adamoell/RoboFootball/Documentation/Controller_Chassis_Unlabelled.jpg

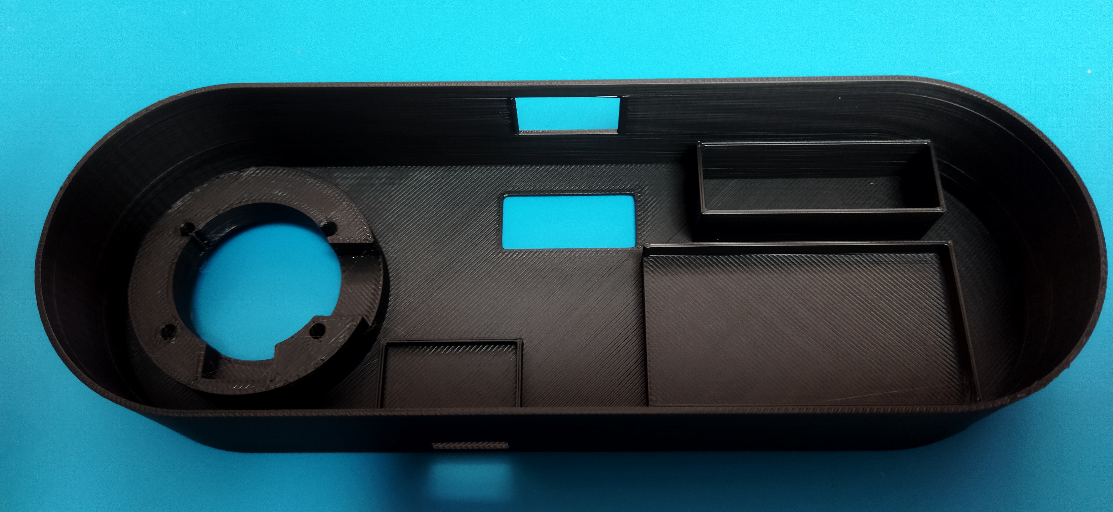
Documentation/Controller_Chassis_Unlabelled.jpg
