adamoell/RoboFootball/RoboFootballer.png

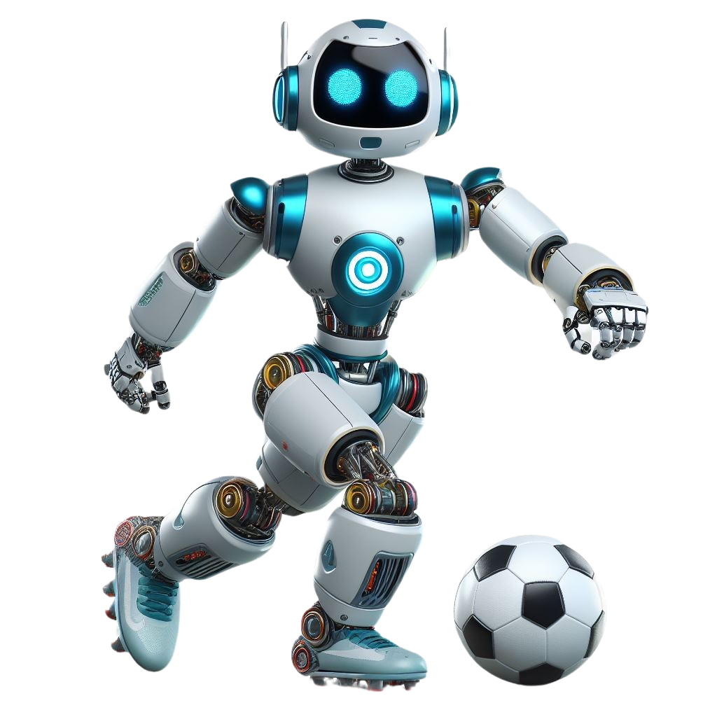
RoboFootballer.png
