adamoell/RoboFootball/3DPrinting/Robot/Kicker/9g-servo-dimensions.jpg

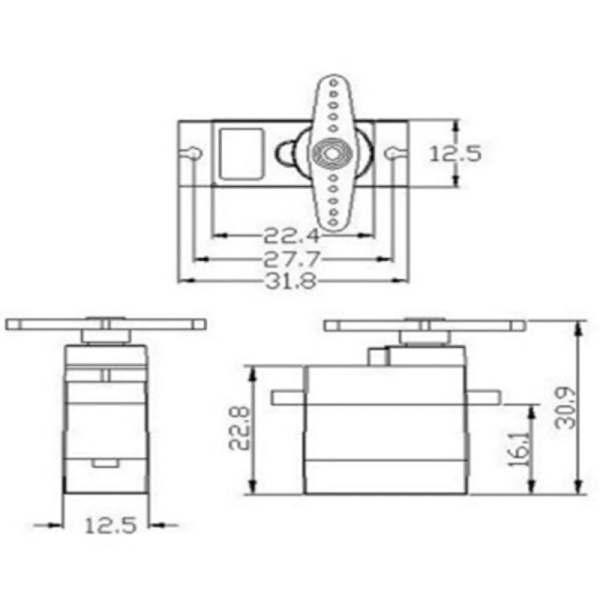
3DPrinting/Robot/Kicker/9g-servo-dimensions.jpg
