adamoell/RoboFootball/3DPrinting/Controller/controller.stl

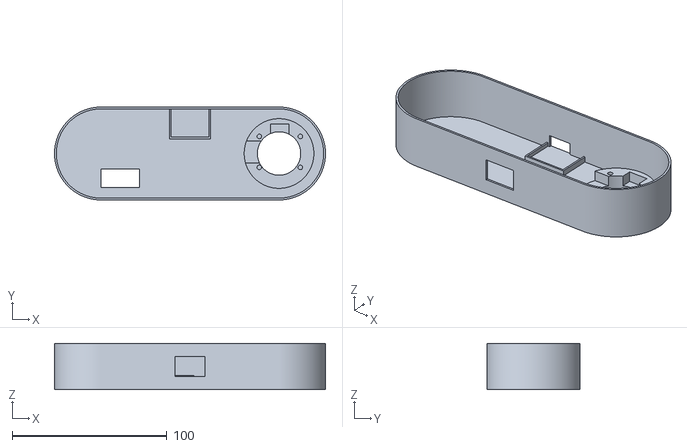
[picture p4: CAD file, 2024-08-09]
3DPrinting/Controller/controller.stl
175.0 x 60.0 x 30.0
