adamoell/RoboFootball/3DPrinting/Goals/goal_l.stl

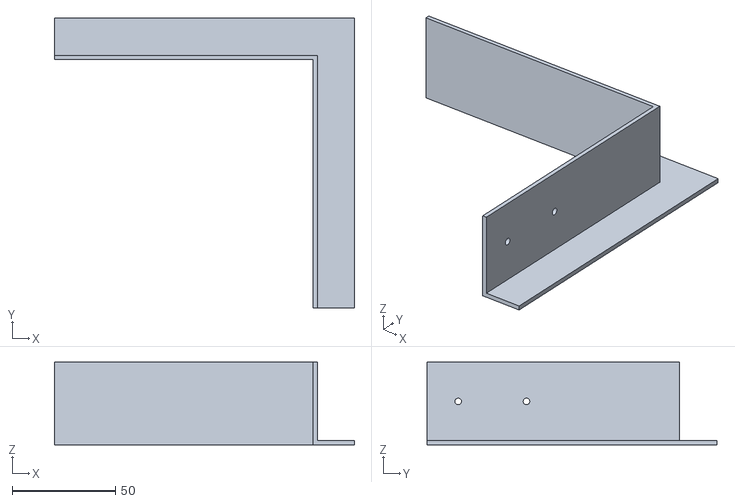
[picture p5: CAD file, 2024-08-09]
3DPrinting/Goals/goal_l.stl
145.0 x 140.0 x 40.0
