adamoell/RoboFootball/3DPrinting/Robot/Chassis/bms_cover.stl

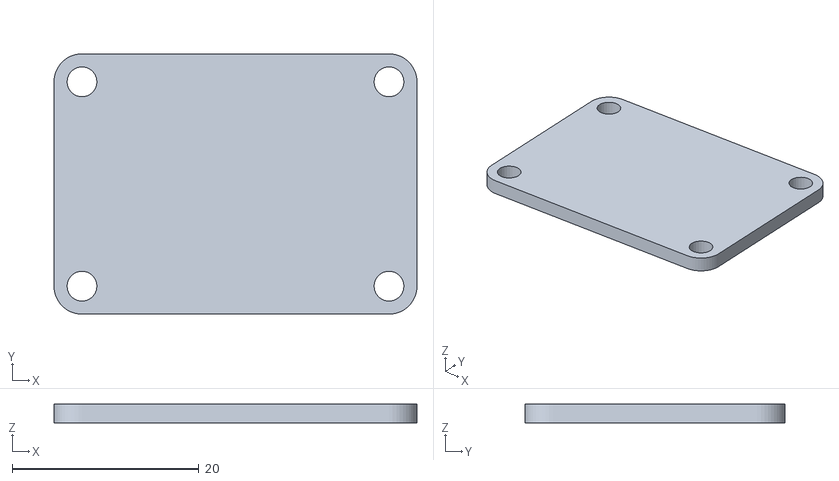
[picture p6: CAD file, 2024-08-09]
3DPrinting/Robot/Chassis/bms_cover.stl
38.9 x 27.9 x 2.00
