adamoell/RoboFootball/3DPrinting/Robot/Kicker/kicker.stl

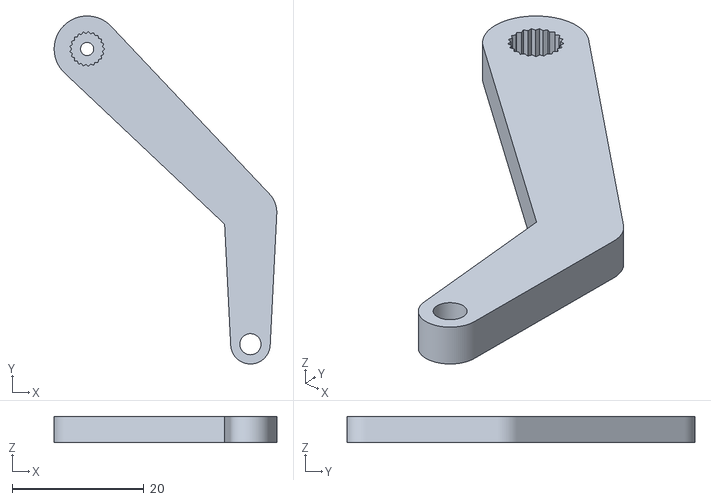
[picture p7: CAD file, 2024-08-09]
3DPrinting/Robot/Kicker/kicker.stl
33.7 x 52.7 x 4.00
