adamoell/RoboFootball/3DPrinting/Robot/switcher.stl

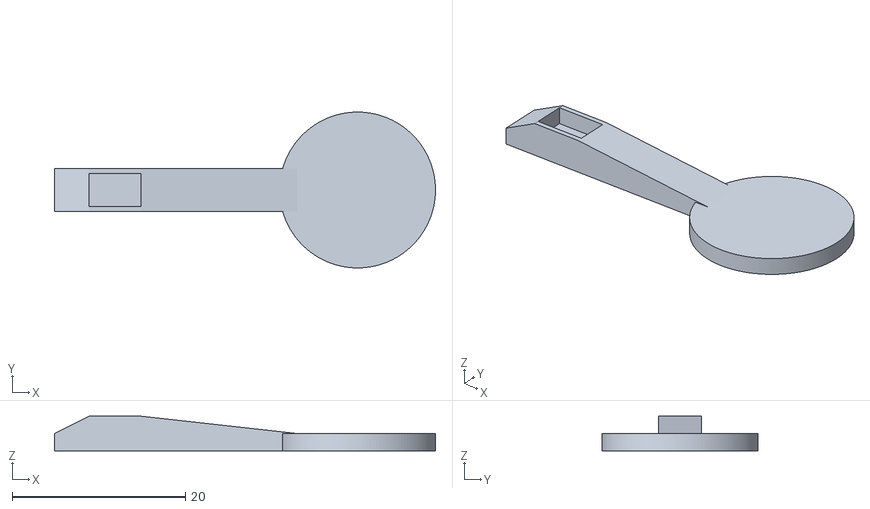
[picture p8: CAD file, 2024-08-09]
3DPrinting/Robot/switcher.stl
44.0 x 18.0 x 4.00
