adamoell/RoboFootball/3DPrinting/Wheels/tyre_mould_top_v2.stl

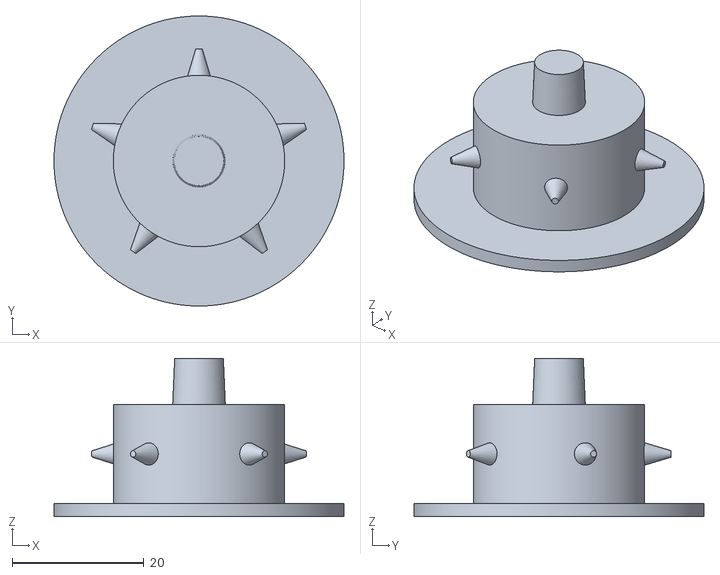
[picture p9: CAD file, 2024-08-09]
3DPrinting/Wheels/tyre_mould_top_v2.stl
44.0 x 44.0 x 24.0
