adamoell/RoboFootball/3DPrinting/Controller/controller_case.stl

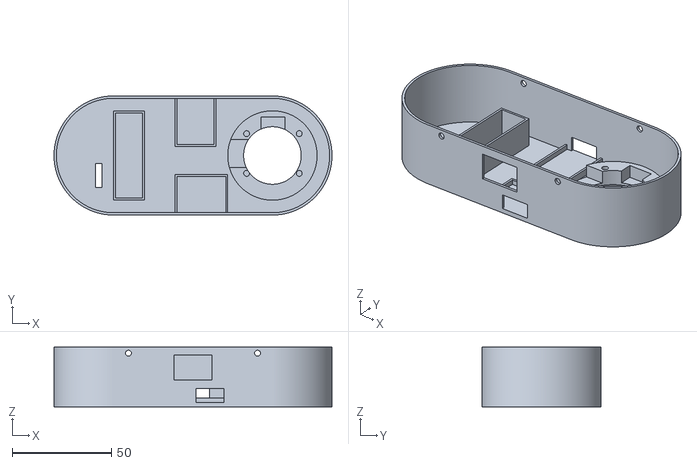
[picture p10: CAD file, 2024-08-09]
3DPrinting/Controller/controller_case.stl
140.0 x 60.0 x 30.0
