adamoell/RoboFootball/3DPrinting/Goals/goal_joiner.stl

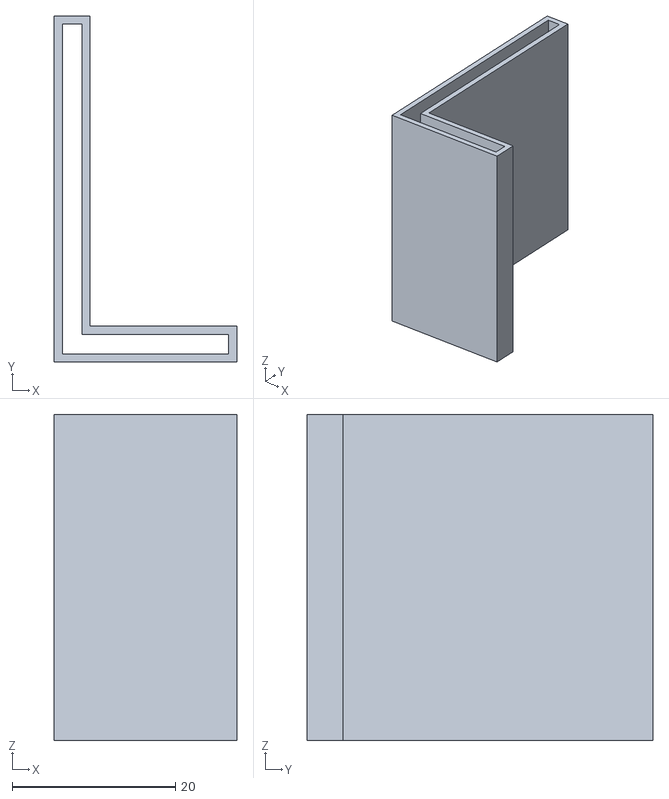
[picture p11: CAD file, 2024-08-09]
3DPrinting/Goals/goal_joiner.stl
22.4 x 42.4 x 40.0
