adamoell/RoboFootball/3DPrinting/Robot/Chassis/chassis.stl

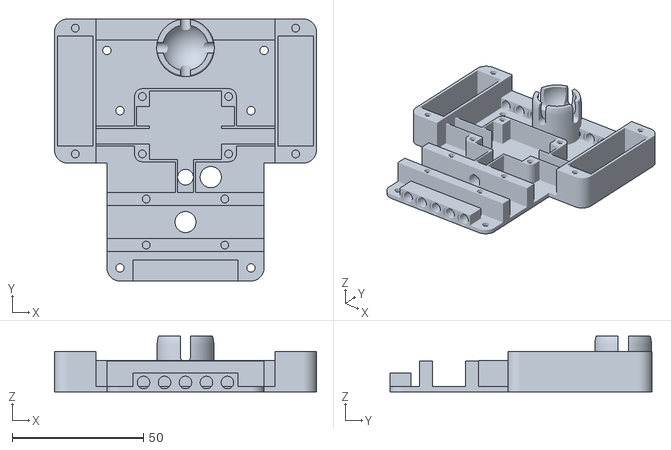
[picture p12: CAD file, 2024-08-09]
3DPrinting/Robot/Chassis/chassis.stl
100.0 x 100.0 x 21.3
