adamoell/RoboFootball/3DPrinting/Robot/Kicker/kicker_mount.stl

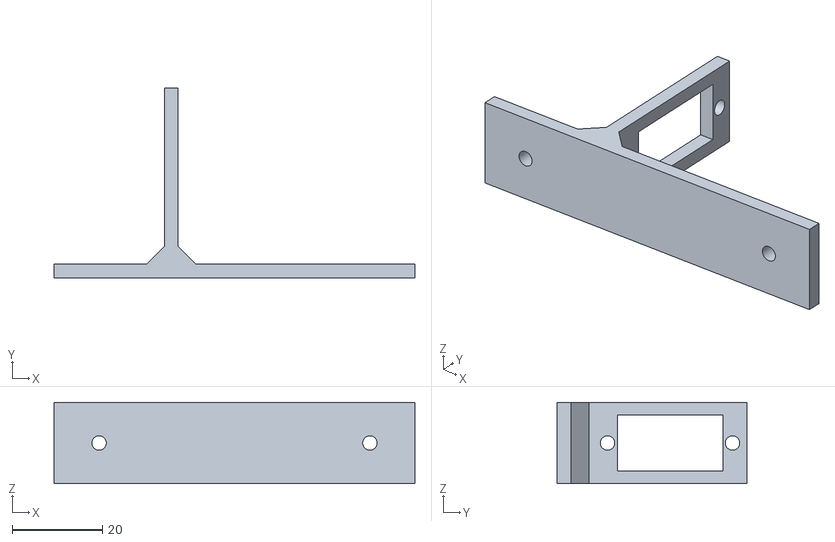
[picture p13: CAD file, 2024-08-09]
3DPrinting/Robot/Kicker/kicker_mount.stl
80.0 x 42.0 x 18.0
