adamoell/RoboFootball/3DPrinting/Wheels/wheel_v2.stl

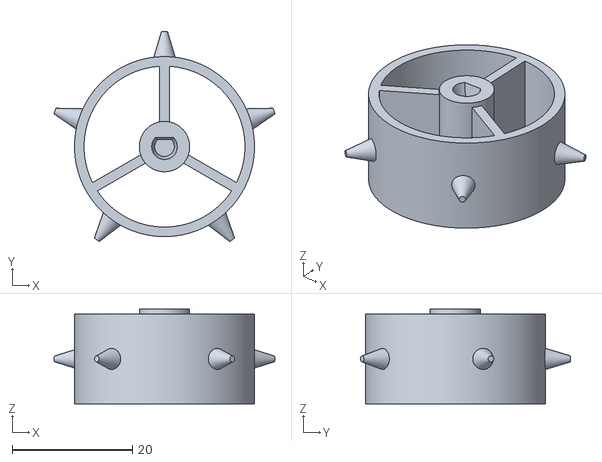
[picture p14: CAD file, 2024-08-09]
3DPrinting/Wheels/wheel_v2.stl
36.8 x 35.0 x 15.8
