adamoell/RoboFootball/3DPrinting/Controller/junctioninsulator.stl

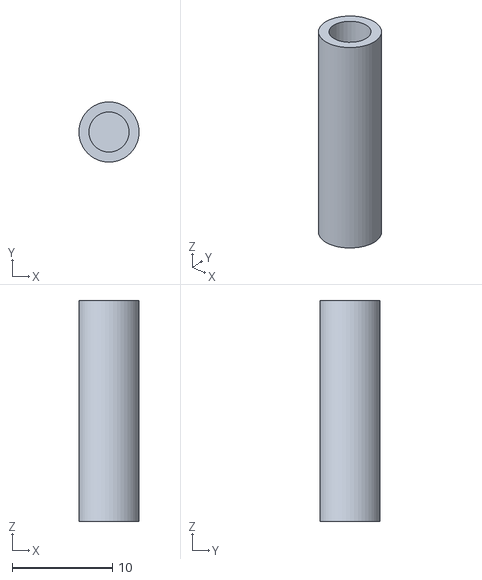
[picture p15: CAD file, 2024-08-09]
3DPrinting/Controller/junctioninsulator.stl
6.00 x 6.00 x 22.0
