adamoell/RoboFootball/3DPrinting/Robot/Chassis/motor_retainer.stl

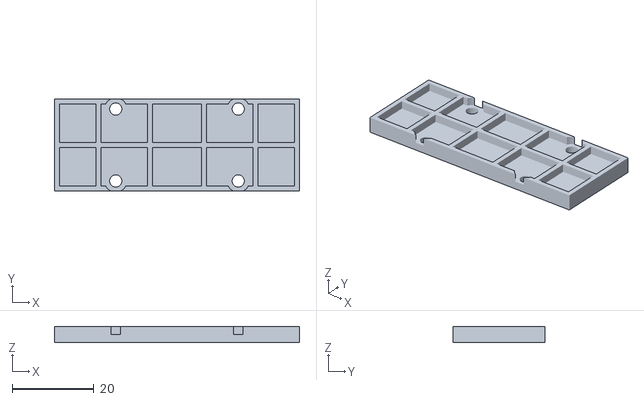
[picture p16: CAD file, 2024-08-09]
3DPrinting/Robot/Chassis/motor_retainer.stl
60.0 x 22.6 x 4.00
