adamoell/RoboFootball/3DPrinting/Robot/Kicker/kicker_boot.stl

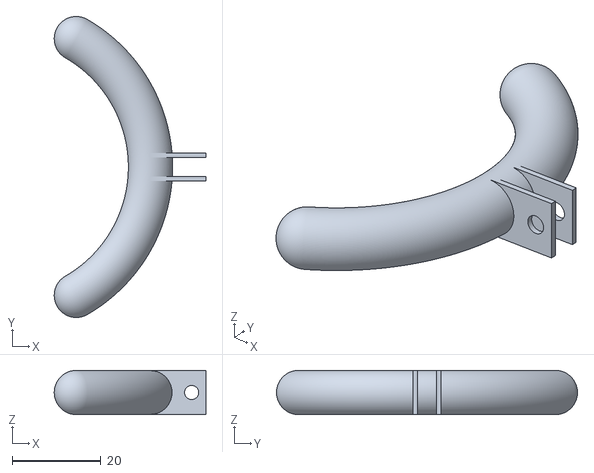
[picture p17: CAD file, 2024-08-09]
3DPrinting/Robot/Kicker/kicker_boot.stl
34.2 x 68.0 x 10.0
