adamoell/RoboFootball/3DPrinting/Wheels/tyre_mould_base_v2.stl

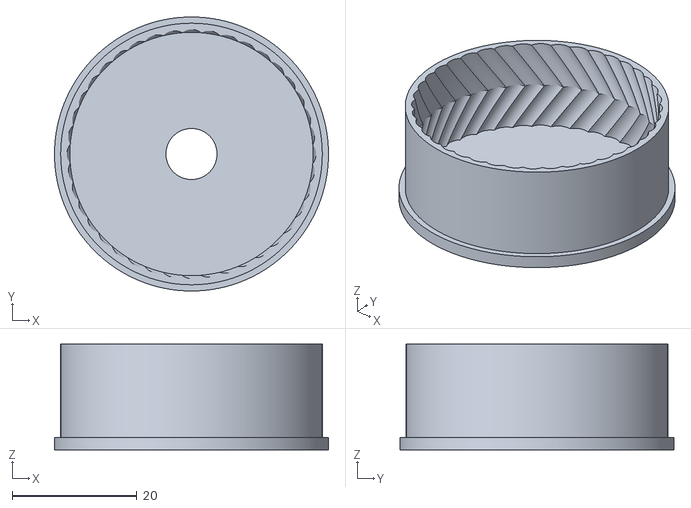
[picture p18: CAD file, 2024-08-09]
3DPrinting/Wheels/tyre_mould_base_v2.stl
44.0 x 44.0 x 17.0
