adamoell/RoboFootball/3DPrinting/Controller/controller_lid.stl

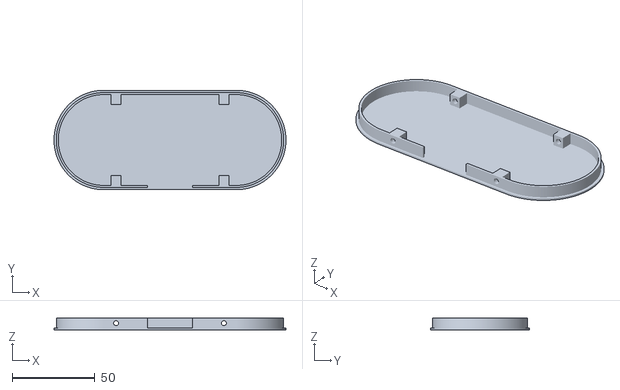
[picture p19: CAD file, 2024-08-09]
3DPrinting/Controller/controller_lid.stl
140.0 x 60.0 x 7.00
