adamoell/RoboFootball/3DPrinting/Robot/Chassis/canopy.stl

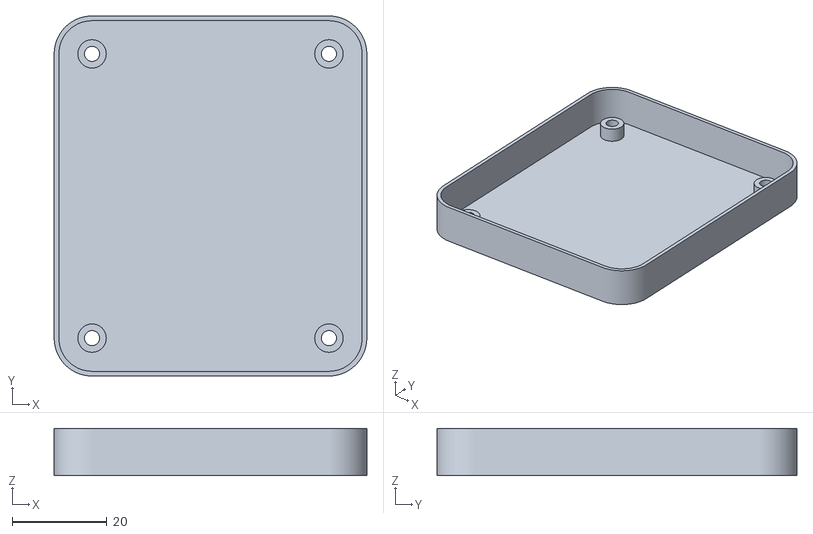
[picture p20: CAD file, 2024-08-09]
3DPrinting/Robot/Chassis/canopy.stl
66.0 x 76.0 x 10.0
