adamoell/RoboFootball/3DPrinting/Robot/Chassis/batt_chamber_cover.stl

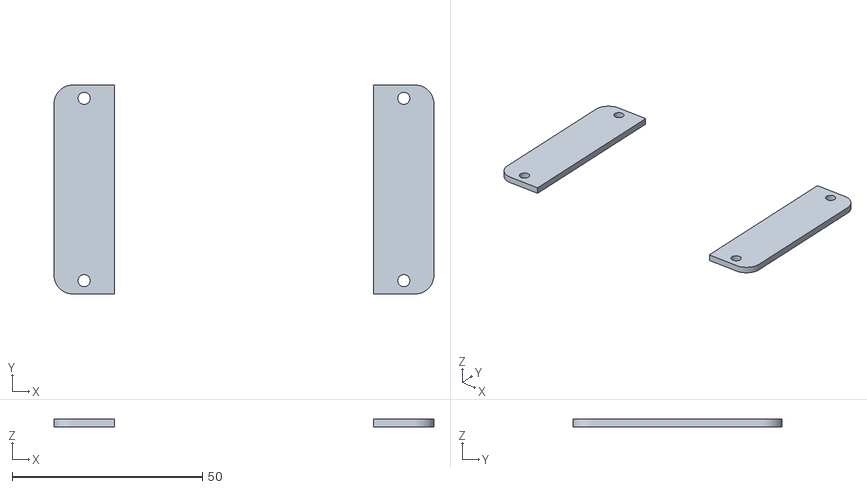
[picture p21: CAD file, 2024-08-09]
3DPrinting/Robot/Chassis/batt_chamber_cover.stl
100.0 x 55.0 x 2.00
