adamoell/RoboFootball/(list of files, cad)

Other CAD files:
3DPrinting/Goals/goal_r.stl
