adamoell/RoboFootball/(list of files, drawings)

Other design files:
PCB/PCB_RoboFootball.json
PCB/SCH_RoboFootball.json
