adamoell/RoboFootball/Code/Robot/servo.py

'''
servo.py: servo motor control library
Copyright (C) 2024 by Adam Oellermann (adam@oellermann.com)
--------------------------------------------------------------------------------
This file is part of RoboFootball.

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
You should have received a copy of the GNU General Public License along with
RoboFootball. If not, see <https://www.gnu.org/licenses/>.
'''
from machine import Pin, PWM
from time import sleep

class Servo:
    def __init__(self, pin, pwm_freq):
        '''
        Inititalise the servo.
        --
        pin: the GPIO pin the servo is connected to
        min_duty: the minimum duty cycle the servo moves at (corresponding to min_angle) (26)
        max_duty: the duty cycle corresponding to max_angle (118)
        min_angle: the minimum angle for the servo (0°)
        max_angle: the maximum angle for the servo (180°)
        pwm_freq: the PWM frequency for the servo (50Hz)
        '''
        self.pwm_freq = pwm_freq
        self.current_duty = None
        self.calibrated = False
        self.servo_pin = pin
        self.servo = PWM(Pin(pin, mode=Pin.OUT))
        self.servo.freq(pwm_freq)

    def auto_calibrate(self, min_duty_spec, max_duty_spec, min_angle, max_angle):
        '''
        Calculate and set calibration values for the servo.
        Manual calibration may yield slightly better results for individual servos.
        --
        min_duty_spec: the duty cycle corresponding to the minimum angle in the spec (0° - 2.5%=0.025 for SG90)
        max_duty_spec: the duty cycle corresponding to the maximum angle in the spec (180° - 12.5%=0.125 for SG90)
        min_angle: the minimum angle for the servo (0°)
        max_angle: the maximum angle for the servo (180°)
        '''
        min_duty = round(min_duty_spec * 1024) # 1024 is the duty cycle range of the ESP
        max_duty = round(max_duty_spec * 1024)
        #print("Autocalibration: min_duty={} max_duty={}".format(min_duty, max_duty))
        self.calibrate(min_duty, max_duty, min_angle, max_angle)
        
    def calibrate(self, min_duty, max_duty, min_angle, max_angle):
        self.min_angle = min_angle
        self.max_angle = max_angle
        self.min_duty = min_duty
        self.max_duty = max_duty
        self.calibrated = True
        
    def degrees_to_duty(self, angle):
        '''
        Convert a given angle in degrees to the appropriate duty cycle.
        --
        angle: the angle in degrees
        '''
    
        angle_fraction = (angle-self.min_angle)/(self.max_angle-self.min_angle)
        duty_range = self.max_duty - self.min_duty
        duty = int(self.min_duty + (angle_fraction * duty_range))
        #print("angle: {} duty: {}".format(angle, duty))
        return(duty)

    def goto(self, angle):
        '''
        Move the servo to a specified angle.
        --
        angle: the angle to move the servo to.
        '''
        if self.calibrated:
            self.goto_duty(self.degrees_to_duty(angle))
        else:
            print("Uncalibrated")
        
    def goto_duty(self, duty):
        '''
        Move the servo by specifiying a duty cycle.
        --
        duty: the duty cycle to send to the servo.
        '''
        if duty != self.current_duty:
            self.servo.freq(self.pwm_freq)
            self.current_duty = duty
            self.servo.duty(duty)

        
class Kicker():
    def __init__(self, pin, freq, rest_angle, kick_angle):
        self.servo = Servo(pin, pwm_freq=freq)
        self.rest_angle = rest_angle
        self.kick_angle = kick_angle
        sg90_min_duty = 0.025 # 2.5% duty cycle for 0° (according to spec)
        sg90_max_duty = 0.125 # 12.5% duty cycle for 180° (according to spec)
        self.servo.auto_calibrate(sg90_min_duty, sg90_max_duty, 0, 180)
        self.down()

    def up(self):
        self.servo.goto(self.kick_angle)
    
    def down(self):
        self.servo.goto(self.rest_angle)
        
    def kick(self):
        print(self.servo.servo)
        self.up()
        sleep(0.1)
        self.down()
