adamoell/RoboFootball/Code/Robot/fx.py

'''
fx.py: robot visual fx
Copyright (C) 2024 by Adam Oellermann (adam@oellermann.com)
--------------------------------------------------------------------------------
This file is part of RoboFootball.

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
You should have received a copy of the GNU General Public License along with
RoboFootball. If not, see <https://www.gnu.org/licenses/>.
'''
import machine, neopixel
from time import sleep
from time import ticks_ms

BLACK = (0,0,0)
RED = (255,0,0)
ORANGE = (255,63,0)
YELLOW = (255,160,0)
GREEN = (0,255,0)
AQUA = (0,255,255)
BLUE = (0,0,255)
PINK = (255,63,255)
PURPLE = (255,0,255)
WHITE = (255,255,255)


class RGB():
    """Class providing RGB facilities"""
    
    def __init__(self, pin=2, num_pixels=4):
        """Initialise the WS2812B LEDs

        Arguments:
        pin -- the GPIO pin number for the WS2812B (default 2)
        num_pixels -- the number of pixels (default 4)
        """
        self.pin = machine.Pin(pin)
        self.num_pixels = num_pixels
        self.np = neopixel.NeoPixel(self.pin, self.num_pixels)
        self.fill( BLACK )
        
    def fill(self, colour):
        """Fill all pixels with the specified colour

        Arguments:
        colour -- tuple with the R/G/B values for the colour
        """
        self.np.fill(colour)
        self.np.write()
        
    def led(self, led, colour):
        """Set the individual LED to the specified colour

        Arguments:
        led: the ordinal number of the LED
        colour: the colour to set
        """
        self.np[led] = colour
        self.np.write()


# TODO include 'polis' into the class
# cycle_start = None
# last_pattern = None
# np = None
# 
# 
# def polis():
#     global cycle_start
#     global last_pattern
# 
#     passive_time = 150 # was 250
#     blink_active = 100 # was 100
#     blink_passive = 50 # was 100
# 
#     now = ticks_ms()
#     if cycle_start is None:
#         cycle_start = now 
#         last_pattern = 0
# 
#     elapsed = now - cycle_start
#     # 250ms low blue
#     if (elapsed >= 0) and (elapsed < passive_time):
#         polis_1() # low blue
#     
#     # 100ms flash bright blue/red, low blue * 3
#     p1 = passive_time
#     if (elapsed >= p1) and (elapsed < (p1+blink_active)):
#         polis_2() # blue / red
#     if (elapsed >= (p1+blink_active)) and (elapsed < (p1+blink_active+blink_passive)):
#         polis_1() # low blue
#     if (elapsed >= (p1+blink_active+blink_passive)) and (elapsed < (p1+blink_active*2+blink_passive)):
#         polis_2() # blue / red
#     if (elapsed >= (p1+blink_active*2+blink_passive)) and (elapsed < (p1+blink_active*2+blink_passive*2)):
#         polis_1() # low blue
#     if (elapsed >= (p1+blink_active*2+blink_passive*2)) and (elapsed < (p1+blink_active*3+blink_passive*2)):
#         polis_2() # blue / red
#     if (elapsed >= (p1+blink_active*3+blink_passive*2)) and (elapsed < (p1+blink_active*3+blink_passive*3)):
#         polis_1() # low blue
#     
#     # 100ms flash red/bright blue low blue * 3
#     p1 = (p1+blink_active*3+blink_passive*3)
#     if (elapsed >= p1) and (elapsed < (p1+blink_active)):
#         polis_3() # blue / red
#     if (elapsed >= (p1+blink_active)) and (elapsed < (p1+blink_active+blink_passive)):
#         polis_1() # low blue
#     if (elapsed >= (p1+blink_active+blink_passive)) and (elapsed < (p1+blink_active*2+blink_passive)):
#         polis_3() # blue / red
#     if (elapsed >= (p1+blink_active*2+blink_passive)) and (elapsed < (p1+blink_active*2+blink_passive*2)):
#         polis_1() # low blue
#     if (elapsed >= (p1+blink_active*2+blink_passive*2)) and (elapsed < (p1+blink_active*3+blink_passive*2)):
#         polis_3() # blue / red
#     if (elapsed >= (p1+blink_active*3+blink_passive*2)) and (elapsed < (p1+blink_active*3+blink_passive*3)):
#         polis_1() # low blue
# 
#     if elapsed >= (p1+blink_active*3+blink_passive*3):
#         cycle_start = now 
#         last_pattern = 0
#         polis_1()
# 
# def polis_1():
#     global last_pattern
#     # low blue
#     if last_pattern != 1:
#         last_pattern = 1
#         np[0] = (0,0,127)
#         np[1] = (0,0,127)
#         np[2] = (0,0,127)
#         np[3] = (0,0,127)
#         np.write()
# 
# def polis_2():
#     global last_pattern
#     # blue/red
#     if last_pattern != 2:
#         last_pattern = 2
#         np[0] = (0,0,255)
#         np[1] = (255,0,0)
#         np[2] = (255,0,0)
#         np[3] = (0,0,255)
#         np.write()
# 
# def polis_3():
#     global last_pattern
#     # red/blue
#     if last_pattern != 3:
#         last_pattern = 3
#         np[0] = (255,0,0)
#         np[1] = (0,0,255)
#         np[2] = (0,0,255)
#         np[3] = (255,0,0)
#         np.write()
