adamoell/RoboFootball/Code/Controller/comms.py

'''
comms.py: ESP-NOW based network communications
Copyright (C) 2024 by Adam Oellermann (adam@oellermann.com)
--------------------------------------------------------------------------------
This file is part of RoboFootball.

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
You should have received a copy of the GNU General Public License along with
RoboFootball. If not, see <https://www.gnu.org/licenses/>.
'''
import network
import espnow
import binascii

def mac2string(mac):
    macstr = ":".join(["{:02X}".format(byte) for byte in mac])
    return(macstr)

def string2mac(addr):
    macbytes = binascii.unhexlify(addr.replace(':', ''))
    return(macbytes)

class Comms:
    def __init__(self, msg_handler=None):
        # activate wlan
        self.sta = None
        self.msg_handler = msg_handler
        self.activate()

    def activate(self):
        # Setup ESPNOW
        self.sta = network.WLAN(network.STA_IF)
        self.sta.active(True)
        if self.sta.active():
            mac = self.sta.config("mac")
            self.mac_address = mac2string(mac)
            
        self.sta.disconnect() # for ESP8266
        self.esp = espnow.ESPNow()
        self.esp.active(True)
        self.add_peer("FF:FF:FF:FF:FF:FF")
        
    
    def add_peer(self, peer):
        try:
            self.esp.add_peer(string2mac(peer))
        except:
            print("error adding peer {}".format(peer))
    
    def get_mac(self):
        return(self.mac_address)
    
    def check_messages(self, timeout=None):
        sender, msg = self.esp.recv(timeout)
        if msg:
            if self.msg_handler != None:
                self.msg_handler(mac2string(sender), msg.decode("utf-8"))
            else:
                print("msg: {}".format(msg))
    
    def get_messages(self, timeout=None):
        sender, msg = self.esp.recv(timeout)
        if msg:
            return((mac2string(sender),msg.decode("utf-8")))
        else:
            return((None,None))
            
            
    def send(self, dest, msg):
        mac = string2mac(dest)
        try:
            self.esp.send(mac,msg)
        except:
            print("Error sending message {} << [{}]".format(dest, msg))

    def broadcast(self, msg):
        self.send("FF:FF:FF:FF:FF:FF", msg)
