adamoell/RoboFootball/(commit log)

2024-03-01 Calibration code for thumbstick.
2024-03-19 Reorganised code, added Servo control library
2024-06-14 Controller test code, assembly docs
2024-08-05 Drive code, reaction game code
    [calibration.cfg, controller.cfg, robot.cfg]
2024-08-08 Updates to joystick/speed mappings
    [_robot.cfg, calibration.cfg, controller.cfg, robot.cfg]
2024-08-09 Controller drive mapping updates
    [calibration.cfg, controller.cfg, robot.cfg]
2024-08-09 Added 3D printables, pitch, PCB, reorganised
    [Goals.scad, PCB_PCB_RoboFootball_2024-06-07.json, SCH_RoboFootball_2024-06-07.json, batt_chamber_cover.stl, bms_cover.stl, calibration.cfg, canopy.scad, canopy.stl]
2024-08-09 Deleted files manually
    [calibration.cfg, controller.cfg, robot.cfg]
2024-08-10 Updates to PCB
    [PCB_RoboFootball.json, SCH_RoboFootball.json]
2024-08-10 Change PCB to power kicker from 5V rail
    [PCB_RoboFootball.json, SCH_RoboFootball.json]
